olliiiver/kicad_qi/README.md

# Qi module designed in KiCad based on TI bq51013B

This is a "works for me" project. It has not been optimised (foreign object detection, max. output, etc) or tested for (unwanted) electromagnetic radiation.

## Photos

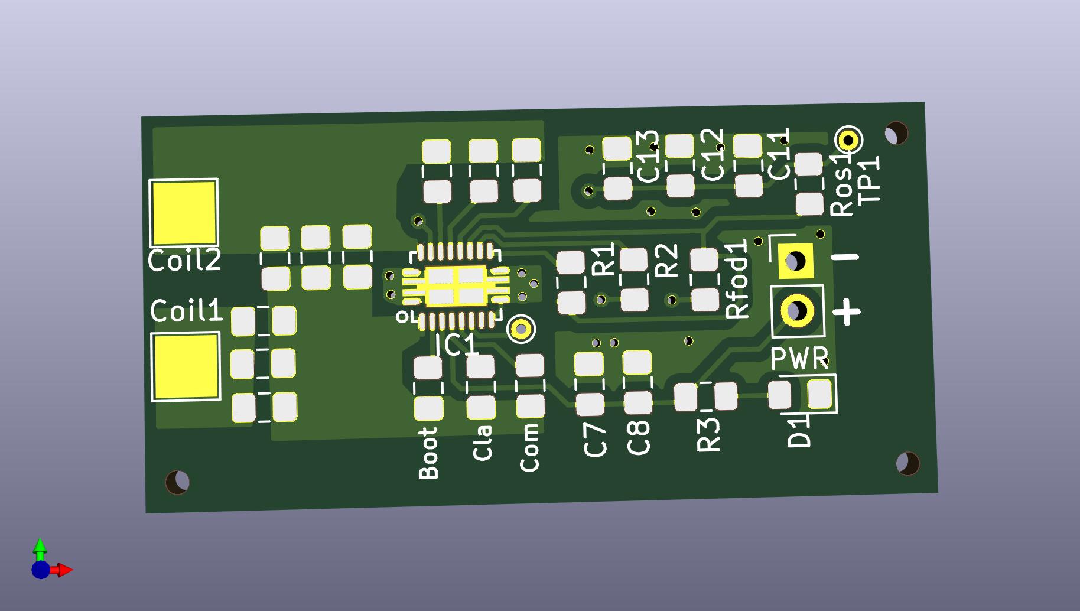
[picture p1: pcb.jpg]
RENDERED


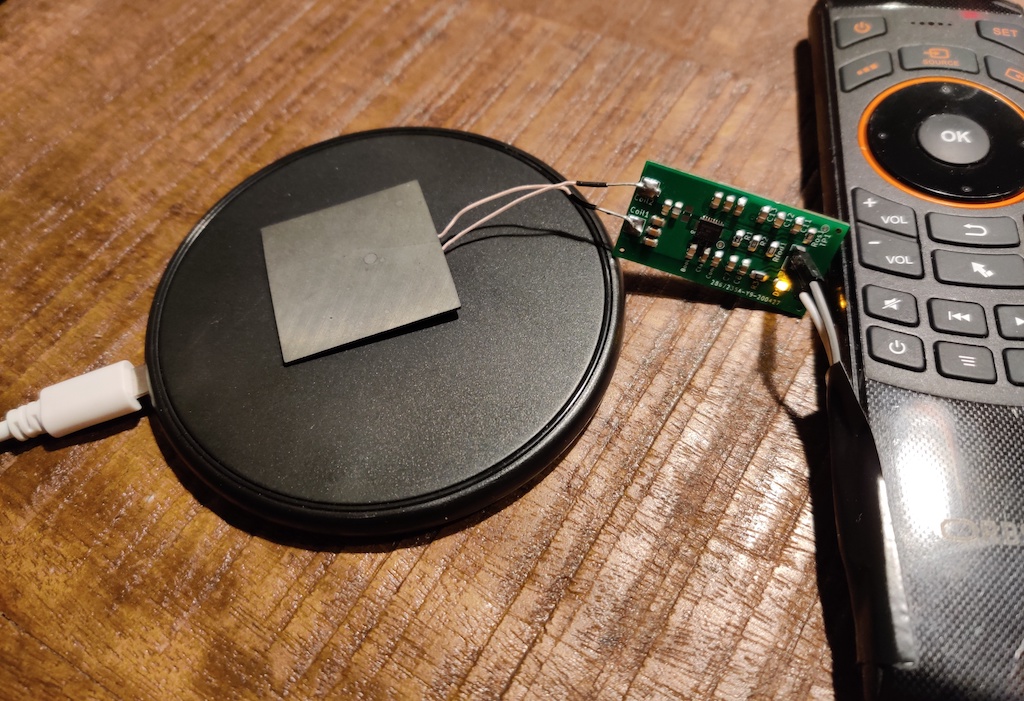
[picture p2: image.jpg]


## BOM

- BQ51013BRHLR: http://www.ti.com/lit/ds/symlink/bq51013b.pdf
- 10 µH 0.15 Ω 3 A Coil (Würth  760308102210): https://www.we-online.de/katalog/datasheet/760308102210.pdf
https://www.conrad.de/de/p/wuerth-elektronik-we-wpcc-760308102210-empfaengerspule-qi-kompatibel-wireless-10-h-0-15-3-a-1-1364999.html
- All resistors and caps are 0805. Caps from coil to IC need to be min. 50V
