olliiiver/kicad_qi/pcb/schema.pdf

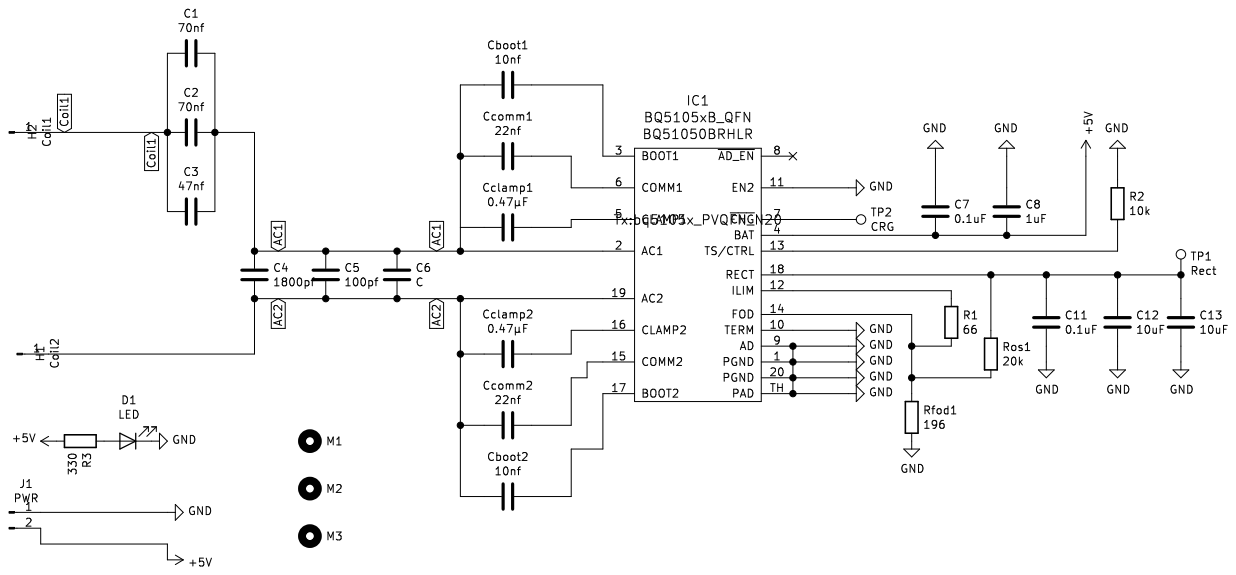
[picture p3: page 1]
