olliiiver/kicad_qi/pcb/final.kicad_pcb

## KiCad design pcb/final.kicad_pcb (2020-05-13)

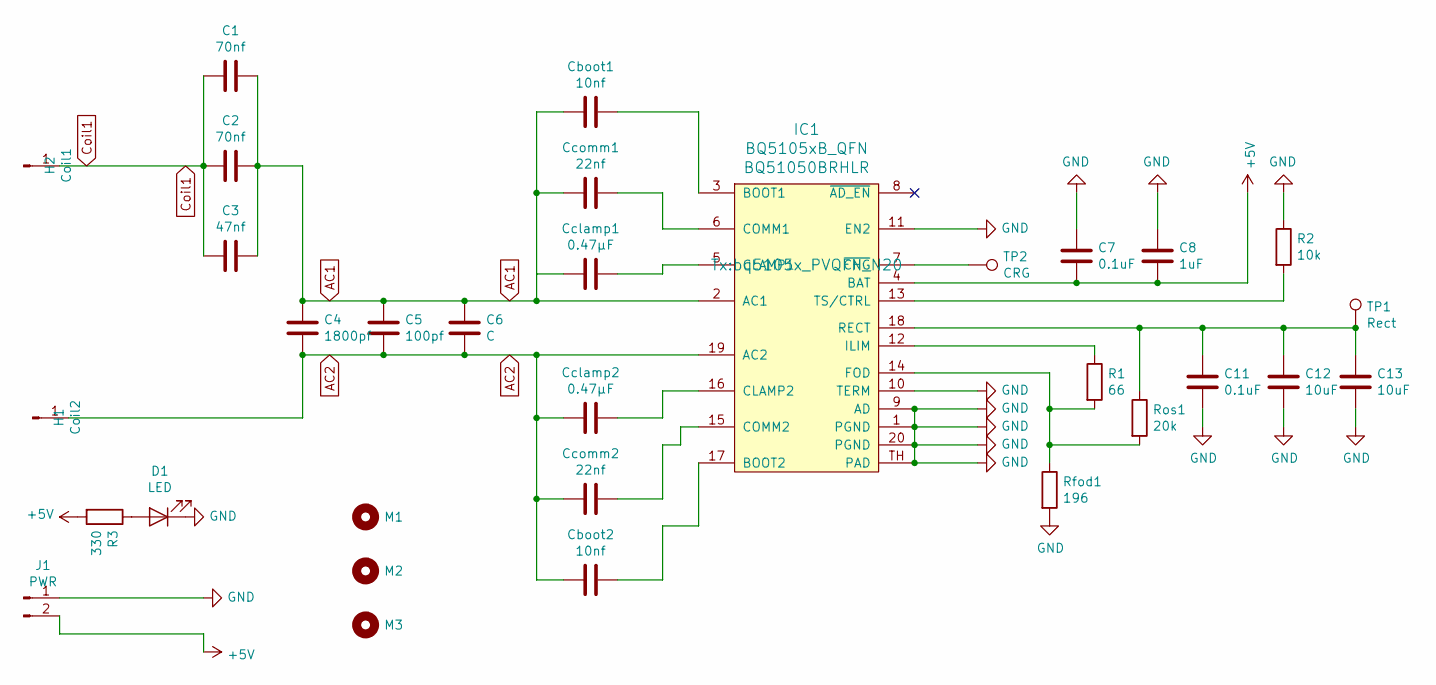
[picture p4: schematic final.sch]

Parts:
C1, C2: 70nf; C_0805_2012Metric_Pad1.15x1.40mm_HandSolder
C3: 47nf; C_0805_2012Metric_Pad1.15x1.40mm_HandSolder
C4: 1800pf; C_0805_2012Metric_Pad1.15x1.40mm_HandSolder
C5: 100pf; C_0805_2012Metric_Pad1.15x1.40mm_HandSolder
C6: C; C_0805_2012Metric_Pad1.15x1.40mm_HandSolder
C7, C11: 0.1uF; C_0805_2012Metric_Pad1.15x1.40mm_HandSolder
C8: 1uF; C_0805_2012Metric_Pad1.15x1.40mm_HandSolder
C12, C13: 10uF; C_0805_2012Metric_Pad1.15x1.40mm_HandSolder
Cboot1, Cboot2: 10nf; C_0805_2012Metric_Pad1.15x1.40mm_HandSolder
Cclamp1, Cclamp2: 0.47μF; C_0805_2012Metric_Pad1.15x1.40mm_HandSolder
Ccomm1, Ccomm2: 22nf; C_0805_2012Metric_Pad1.15x1.40mm_HandSolder
Coil1: H2; TestPoint_Pad_3.0x3.0mm
Coil2: H1; TestPoint_Pad_3.0x3.0mm
D1: LED; LED_0805_2012Metric_Pad1.15x1.40mm_HandSolder
IC1: BQ5105xB_QFN; bq5105x_PVQFN_N20; MPN BQ51050BRHLR
J1: PWR; PinHeader_1x02_P2.54mm_Vertical
M1, M2, M3: MountingHole; MountingHole_1152
R1: 66; R_0805_2012Metric_Pad1.15x1.40mm_HandSolder
R2: 10k; R_0805_2012Metric_Pad1.15x1.40mm_HandSolder
R3: 330; R_0805_2012Metric_Pad1.15x1.40mm_HandSolder
Rfod1: 196; R_0805_2012Metric_Pad1.15x1.40mm_HandSolder
Ros1: 20k; R_0805_2012Metric_Pad1.15x1.40mm_HandSolder
TP1: Rect; TestPoint_THTPad_D1.0mm_Drill0.5mm
TP2: CRG; TestPoint_THTPad_D1.0mm_Drill0.5mm

Connections:
+5V: C7.2, C8.2, IC1.4 (BAT), J1.2, R3.2
AC1: C1.1, C2.1, C3.1, C4.1, C5.1, C6.1, Cboot1.2, Cclamp1.2, Ccomm1.2, IC1.2 (AC1)
AC2: C4.2, C5.2, C6.2, Cboot2.2, Cclamp2.2, Ccomm2.2, Coil2.1, IC1.19 (AC2)
Coil1: C1.2, C2.2, C3.2, Coil1.1
GND: C7.1, C8.1, C11.2, C12.2, C13.2, D1.1 (K), IC1.1 (PGND), IC1.9 (AD), IC1.10 (TERM), IC1.11 (EN2), IC1.20 (PGND), IC1.TH (PAD), J1.1, R2.1, Rfod1.2
unnamed: C11.1, C12.1, C13.1, IC1.18 (RECT), Ros1.1, TP1.1
unnamed: Cboot1.1, IC1.3 (BOOT1)
unnamed: Cboot2.1, IC1.17 (BOOT2)
unnamed: Cclamp1.1, IC1.5 (CLAMP1)
unnamed: Cclamp2.1, IC1.16 (CLAMP2)
unnamed: Ccomm1.1, IC1.6 (COMM1)
unnamed: Ccomm2.1, IC1.15 (COMM2)
unnamed: D1.2 (A), R3.1
unnamed: IC1.7 (~CHG), TP2.1
unnamed: IC1.12 (ILIM), R1.1
unnamed: IC1.13 (TS/CTRL), R2.2
unnamed: IC1.14 (FOD), R1.2, Rfod1.1, Ros1.2

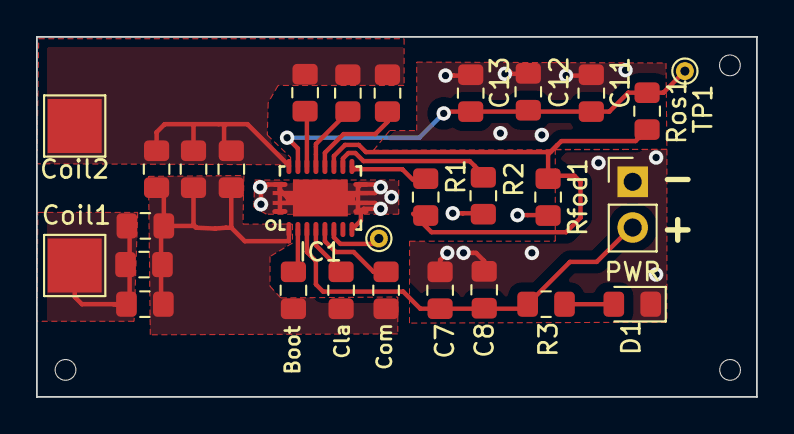
[picture p5: board final.kicad_pcb from above]

Board: 2 copper layers, 40.0 x 20.0 mm, 32 parts (0 on the bottom side), 17 nets.
