olliiiver/kicad_qi/(threads)

Thread 1 (2021-03-17):

What is the value of C6?

BG7UHS, 2021-03-17:
What is the value of C6?

olliiiver, 2021-03-17:
Hi. C6 has not been placed.

BG7UHS, 2021-03-21:
Excuse me, is the final output of this circuit 5V?

BG7UHS, 2021-03-21:
I am missing some electronic components here.  I used a multimeter to measure the output and it was only 4.1V.  It is estimated to be related to the lack of electronic components.  The following circuit is TP5400, a lithium battery charging and discharging integrated circuit.
![Uploading IMG_20210321_225514__01.jpg…]()

olliiiver, 2021-03-21:
I think the hardest part is getting the chip talking to the charger. Great to see that you have achieved that by just using a wire. However, that could also be a problem, because Qi regulates power continuously. My sample outputs 5V really stable.

BG7UHS, 2021-03-25:
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
I changed multiple coils.4.1V is still displayed.  I don't know where the problem is.

BG7UHS, 2021-03-25:
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
I use bq51050B according to the schematic diagram.  4.1V is displayed. Replace bq51013b to 4.9V.  .

Thread 2 (2025-06-25):

Circuit is not working!

KrizA123681, 2025-06-25:
I made BQ51013B circuit for wireless charger from your circuit reference. But, my PCB is not working and not gives output voltage. I made this PCB as a flex PCB.
Here, I attach my circuit schematic.

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
